Marco-vermeulen/Linefollower/readme.md

# LineFollower
<br />
<br />
[image](https://user-images.githubusercontent.com/115167105/208161985-66a62015-a1b9-4a16-8751-3cd92b4f2e4c.png)
<br />
<br />
  
## specifications
<br />
microcontroller: Arduino Mega 2560
<br />
motors: Hyuduo 6VDC-600 RPM
<br />
h-bridge: DRV8833
<br />
sensors: QTR8-A
<br />
batteries: 2x Samsung INR18650-35E
<br />
wireless communication: HC-05
<br />
distance sensor - motors: 10,8 cm
<br />
weight: 302 g
<br />
speed: 0,399 m/s
<br />
