Marco-vermeulen/Linefollower/code/proof of concepts/sensor/POC_SENSOR_STURING_QTR8RC.pdf

# Proof Of Concept: Sensor sturing QTR8-

RC

## SCHEMA

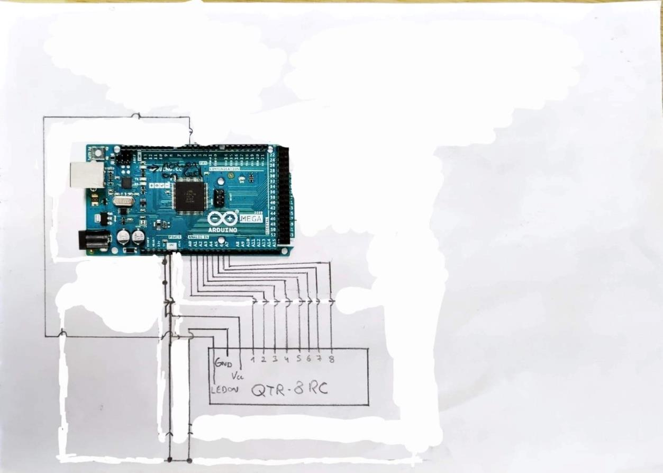
[picture p1: figure]

## CODE

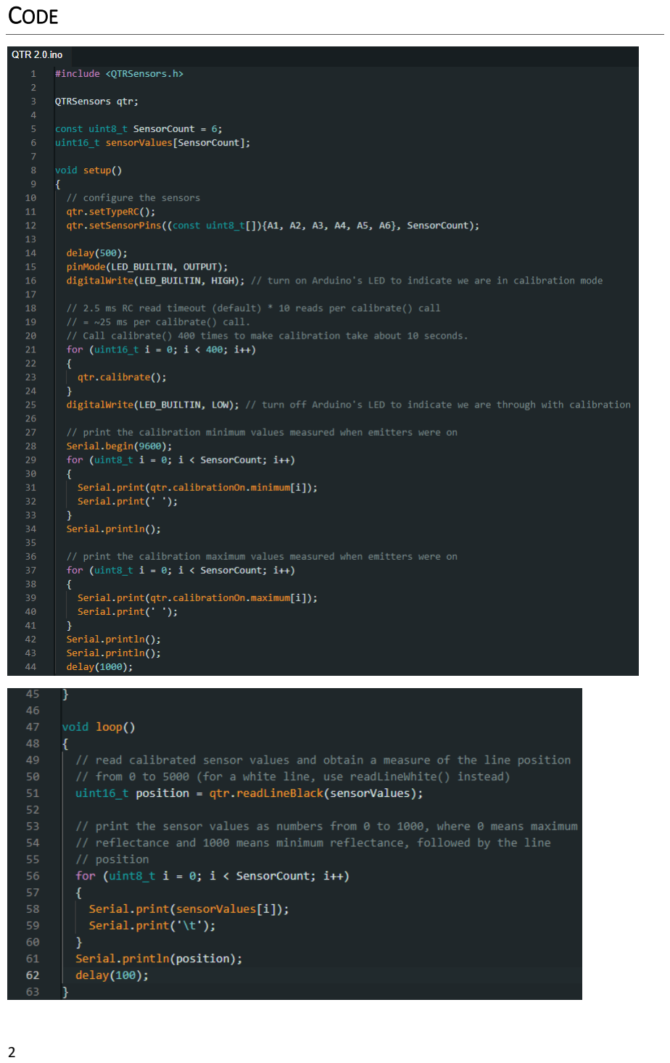
[picture p2: page 2]

2

3

## UITLEG

Als de sensor is aangesloten op de arduino, steken we onze arduino in de usb en uploadden we ons programma op de arduino en openen we de seriële monitor.

Daarna zal de arduino na opstart de sensor calibreren. Na de calibratie zal de sensor een value geven van 0 – 1000 aan de hand van de kleursterkte van het kleur “zwart” in de seriële monitor.
