Marco-vermeulen/Linefollower/code/proof of concepts/wireless communication/POC_BLUETOOTH_MODULE_STURING_HC05.pdf

# Proof Of Concept: Bluetooth module sturing (HC-05)

## SCHEMA

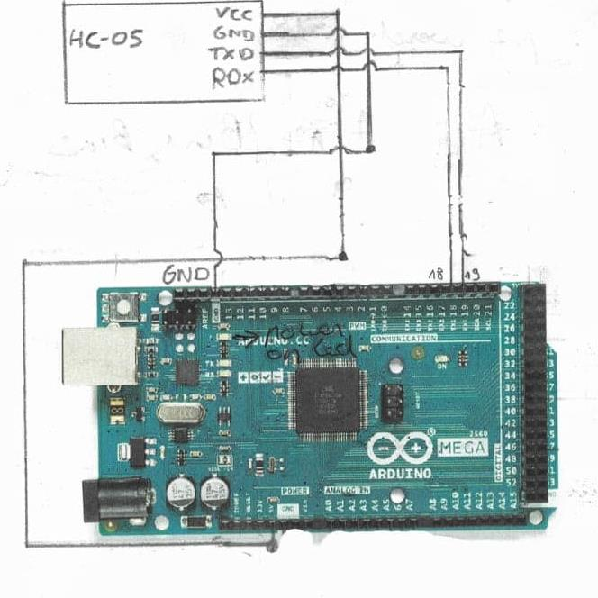
[picture p3: figure]

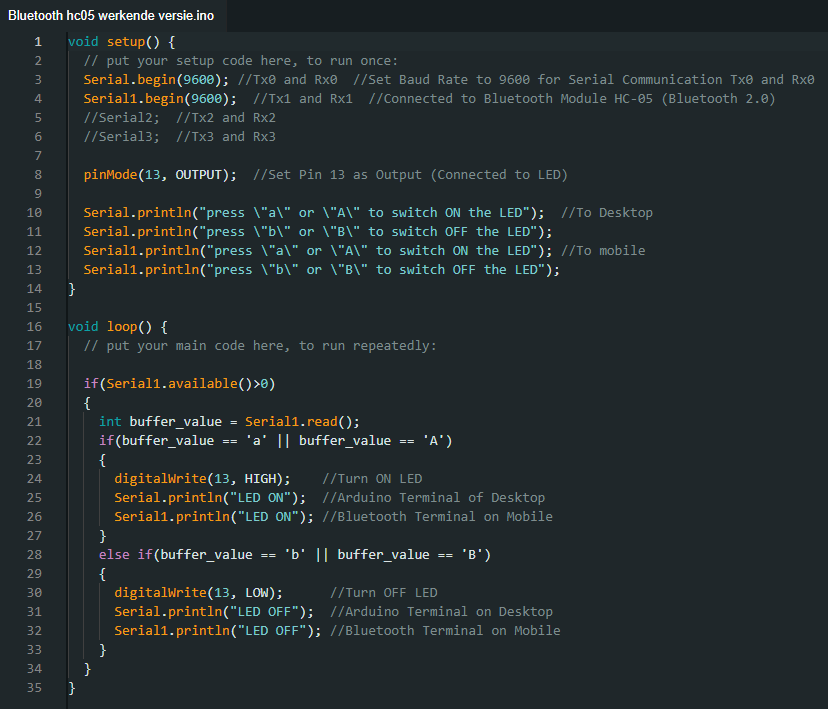
[picture p4: figure]

2

## CODE

## UITLEG

we leggen de arduino aan een voedingsspanning, de bluetooth module zal starten. We verbinden ons gsm met de bluetooth module door een app te installeren waarmee we via bluetooth serieel kunnen commmuniceren. Eenmaal dat gebeurt is, gaan we het programma uploadden. Als bevestiging dat het programma is upgeloadded, krijgen we een boodschap zowel op ons gsm “ en op het IDE terminal dat we een led kunnen aansturen door de boodschappen “a” of “b” te sturen, respectievelijk aan/uit. Als we een a of b sturen, zetten we ons on-board led aan of uit. En per commando dat we sturen krijgen we ook antwoord of de led aan of uit is op onze terminal.
