Marco-vermeulen/Linefollower/code/proof of concepts/hbridge/POC_HBRUG_STURING_MET_2DCMOTOREN_DVR8833.pdf

# Proof Of Concept: H-brug sturing met 2 DC motoren (DRV8833)

## SCHEMA

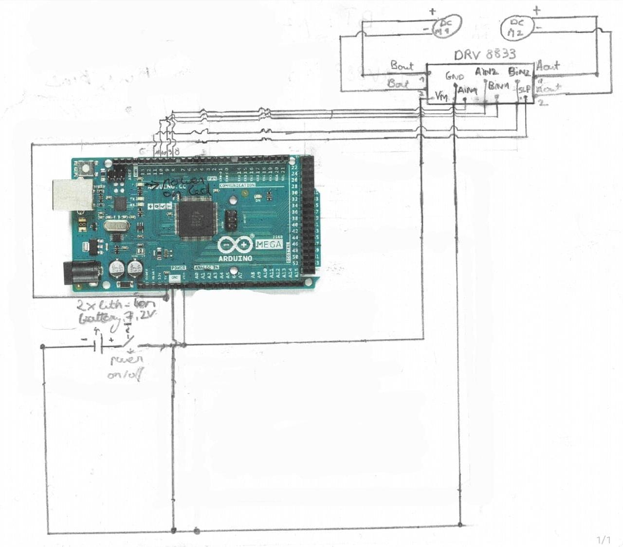
[picture p5: figure]

## CODE

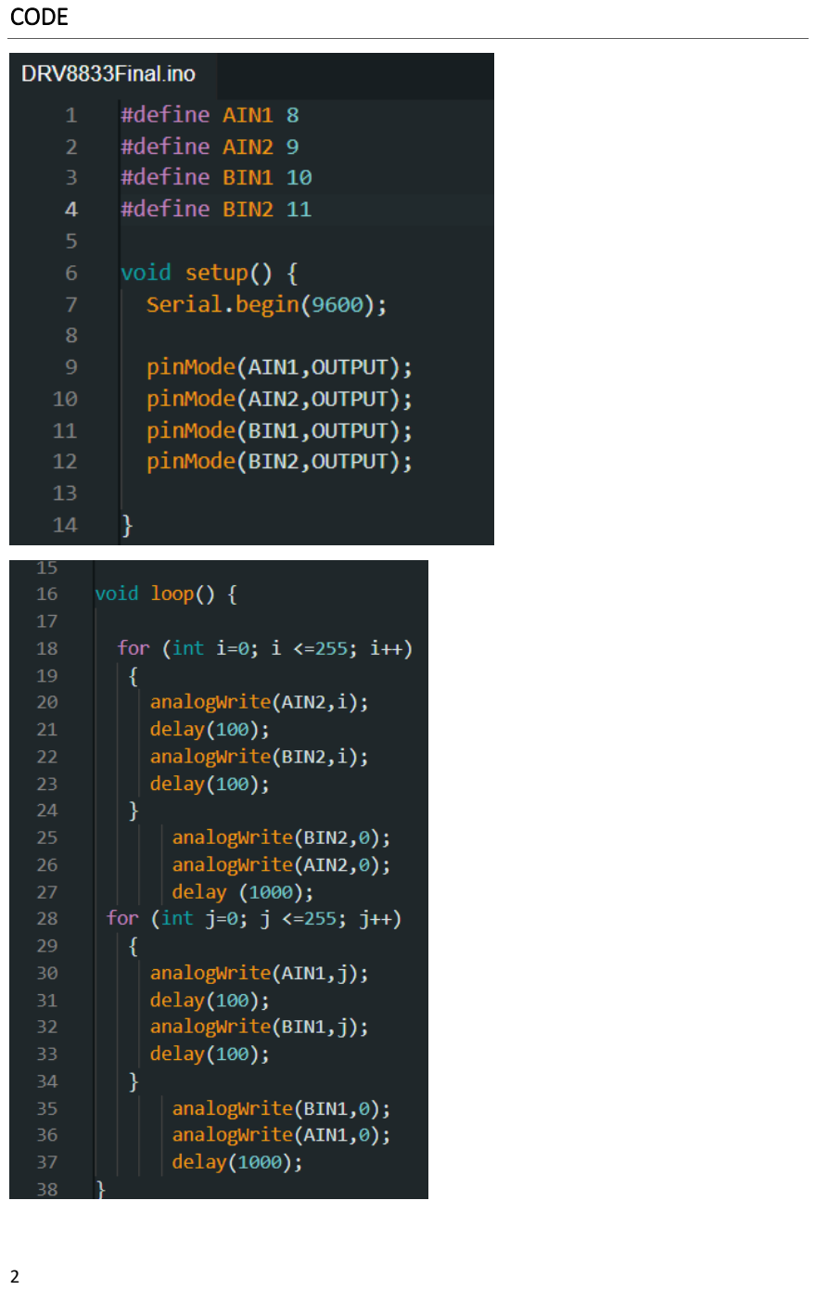
[picture p6: page 2]

2

3

## UITLEG

we sluiten alles aan volgens het schema en we uploadden deze code naar de arduino.
Er zijn dus 2 for loops gemaakt met als het volgende de bedoeling: loop 1 zal beide motoren trapsgewijs met verhoging van 1 byte per cycle voorwaarts aansturen. De motoren zullen dan van een zeer lage snelheid tot topsnelheid aangestuurd worden in de voorwaartste richting. Als loop 1 voltooid is, zal loop 2 starten. Die doet hetzelfde als loop 1, maar stuurt de motoren achterwaarts. Als lop 2 gedaan is zal het weer beginnen met loop 1.
