Marco-vermeulen/Linefollower/bill of materials/readme.md

## bill of materials
<br />

|volgnummer| naam | omschrijving | nieuw/recup | kostprijs/stuk  | aantal  | subtotaal |
|---|---|---|---|---|---|---|
| 1|Arduino Mega | controller | recup |42.00 EUR | 1 |42.00 EUR  |
| 2|HC-05 | bluetooth module | nieuw |6.99 EUR | 1 |6.99  EUR  |
| 3|Weerstand 1K | weerstand | nieuw |0.10 EUR | 1 |0.10  EUR  |
| 4|drukknop | drukknop | recup |0.20 EUR | 1 |0.20  EUR  |
| 5|Motoren | Hyuduo 600RPM 6V | nieuw |13.42 EUR | 2 |26.84 EUR  |
| 6|DRV8833 | H-brug | nieuw |7.95 EUR | 1 |7.95  EUR  |
| 7|LED | LED run/stop | recup |0.33 EUR | 1 |0.33  EUR  |
| 8|Batterijen | INR18650-35E | nieuw |10.02 EUR | 2 |20.04 EUR  |
| 9|schakelaar | aan/uit schakelaar | nieuw |2.75 EUR | 1 |2.75  EUR  |
| 10|QTR-8A | sensor zwarte lijn | nieuw |13.65 EUR | 1 |13.65  EUR |
| 11|wielen | wielen voor motoren | recup |2.95 EUR | 2 |5.90  EUR  |
| 12|kabels | M-M,F-F,M-F 120 st | nieuw |6.99 EUR | 1 |6.99  EUR  |
| 13|Ductape rol | bescherming kabels motoren | nieuw |9.38 EUR | 1 |9.38  EUR  |
| 14|schroeven 200 st| montage arduino, hoogte afstelling van neus | recup |5.33 EUR | 1 |5.33  EUR  |
| 15|lijm | bevestiging QTR-8A en motoren | nieuw |16.38 EUR | 1 |16.38  EUR |
| 16|Batterij houder | batterij houder voor batterij met aansluitdraden | nieuw |1.29 EUR | 2 |2.58 EUR |
| 17|Breadbord | klein breadbord voor montage HC-05, DRV8833, LED, Weerstand; drukknop en schakelaar| recup |5.51 EUR | 1 |5.51  EUR  |
